unitybighead/active-marker-hardware/LED-module/README.md

# active-marker/LED-module

These circuits are desinged using KiCad 6.  
In order to order multiple boards at the same time, we will copy the wiring on the PCB editor. Since the number of parts differs from the circuit diagram, repainting the wiring will result in many errors and unconnected wiring. Please be careful when ordering board production.  
Links for NeoPixel modules are provided in LED-module.csv.

## 1655side

They are used as the four outer markers to identify the ID.

## 1655center

They are used as the center marker to identify team color.  
In the experiments, the smaller one is used.  


## 3484, 1655single
They didn't emit enough light to be used as markers, so they ended up not being used. They are left here for future reference.
