unitybighead/active-marker-hardware/LED-module/LED-module.csv

name | url
3484 | https://www.mouser.jp/ProductDetail/Adafruit/3484?qs=HXFqYaX1Q2zAi4aM%252Bec1%2Fw%3D%3D
1655 | https://www.mouser.jp/ProductDetail/Adafruit/1655?qs=GURawfaeGuATdkjqVQs49g%3D%3D
