unitybighead/active-marker-hardware/base_plate.step

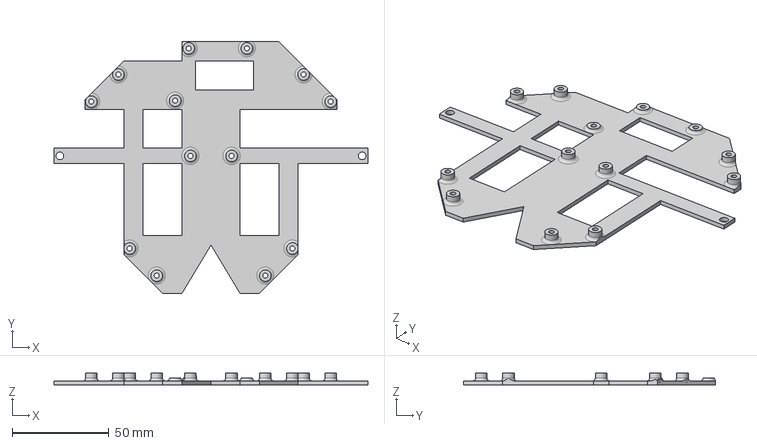
[picture p1: CAD file, 2025-02-01]
base_plate.step
162.0 x 130.0 x 6.05 mm
