unitybighead/active-marker-hardware/filter.step

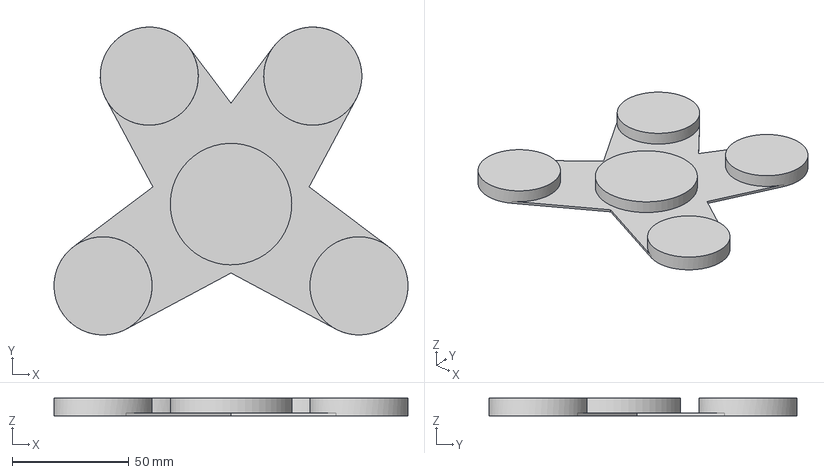
[picture p2: CAD file, 2025-02-01]
filter.step
151.5 x 131.8 x 7.50 mm
