unitybighead/active-marker-hardware/active-marker/active-marker-pcb/active-marker-pcb.kicad_pcb

## KiCad design active-marker/active-marker-pcb/active-marker-pcb.kicad_pcb (2024-10-10)

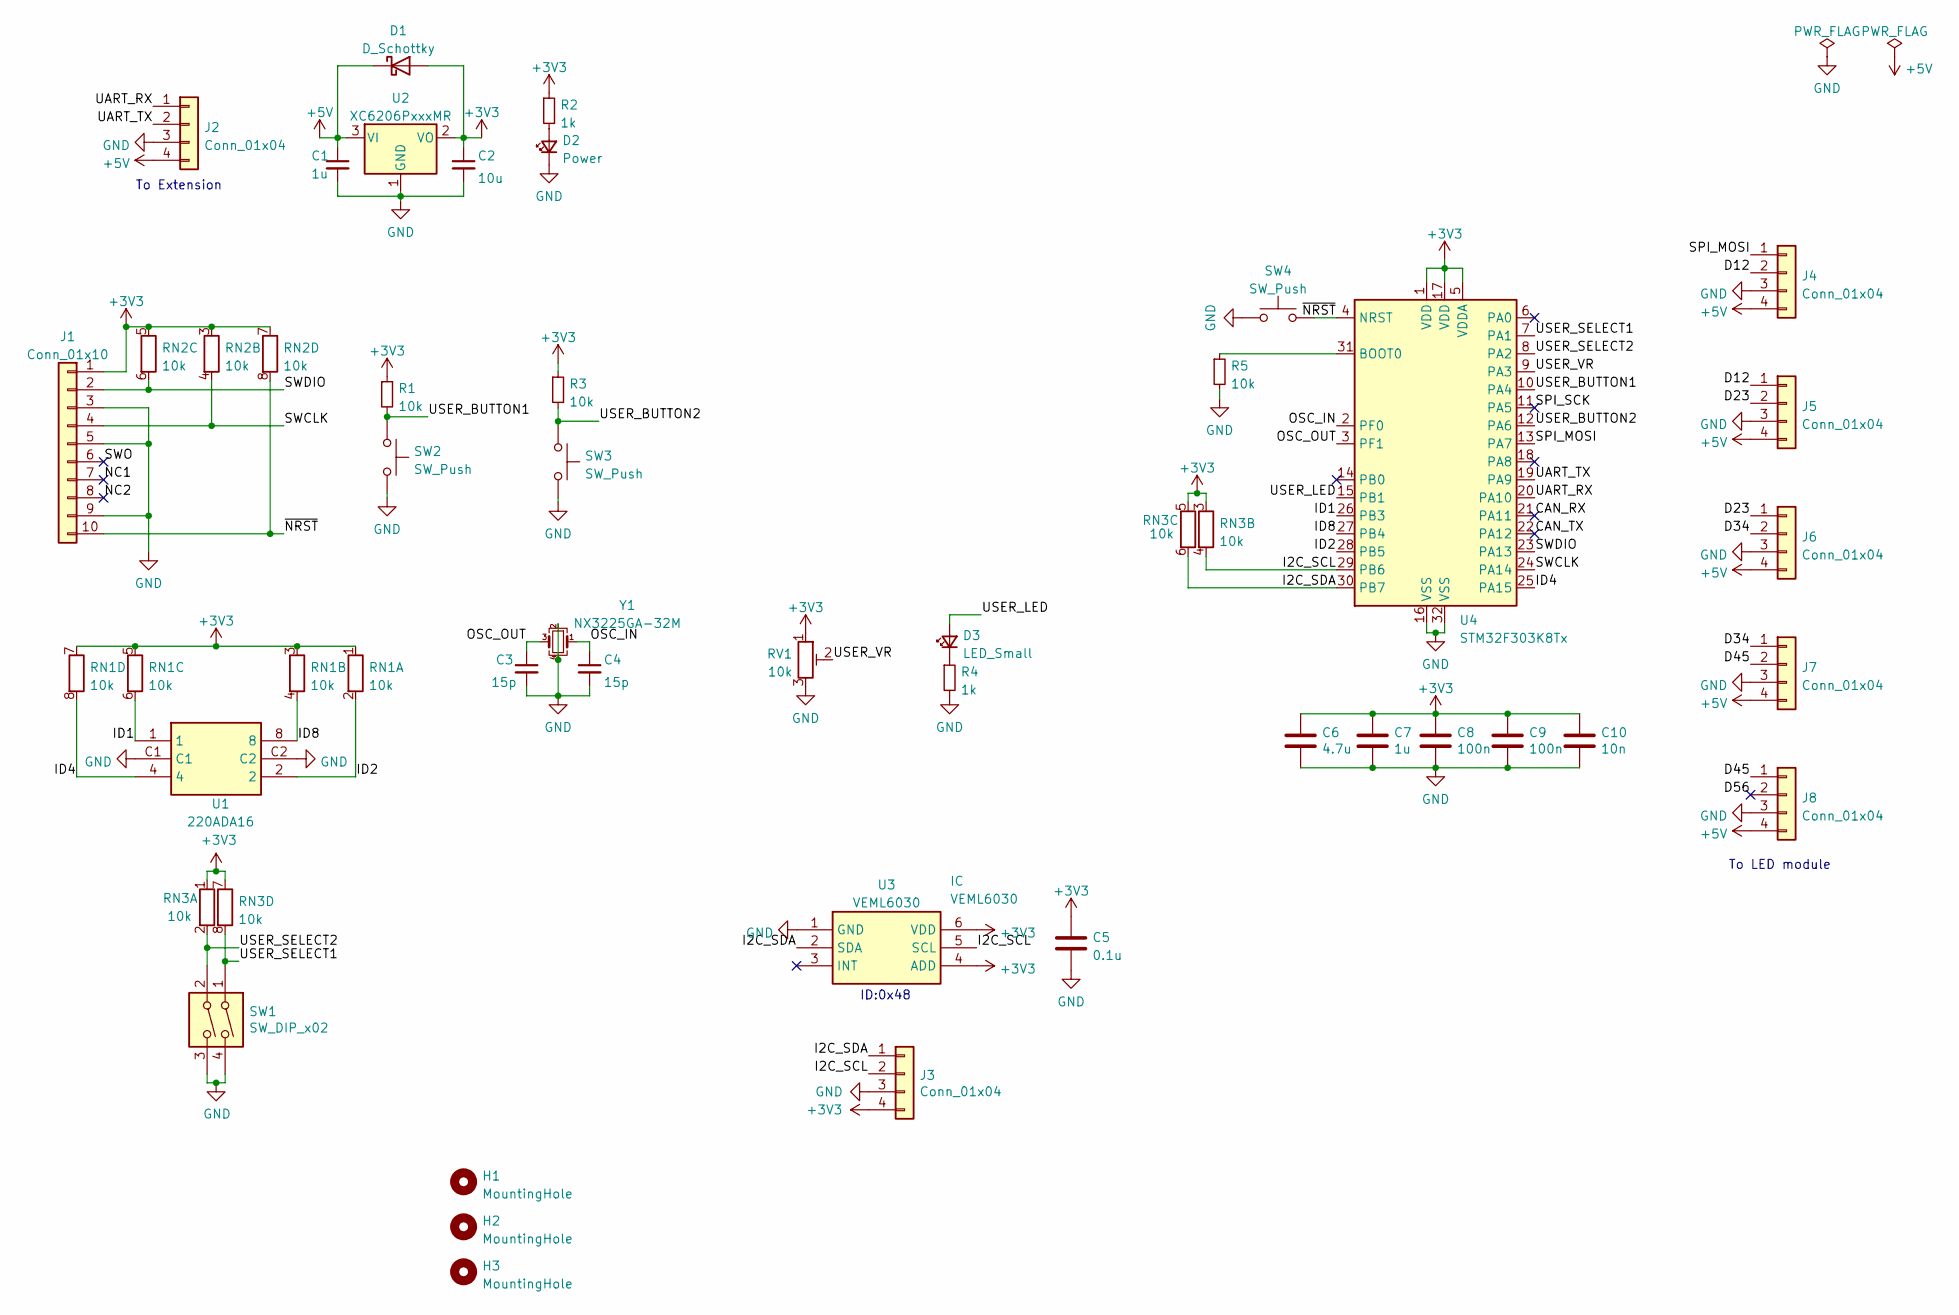
[picture p3: schematic active-marker-pcb.kicad_sch, Active Marker for RoboCup SSL]

Parts:
C1, C7: 1u; C_0603_1608Metric_Pad1.08x0.95mm_HandSolder
C2: 10u; C_0603_1608Metric_Pad1.08x0.95mm_HandSolder
C3, C4: 15p; C_0603_1608Metric_Pad1.08x0.95mm_HandSolder
C5: 0.1u; C_0603_1608Metric_Pad1.08x0.95mm_HandSolder
C6: 4.7u; C_0603_1608Metric_Pad1.08x0.95mm_HandSolder
C8, C9: 100n; C_0603_1608Metric_Pad1.08x0.95mm_HandSolder
C10: 10n; C_0603_1608Metric_Pad1.08x0.95mm_HandSolder
D1: D_Schottky; D_SOD-523
D2: Power; LED_0603_1608Metric_Pad1.05x0.95mm_HandSolder
D3: LED_Small; LED_0603_1608Metric_Pad1.05x0.95mm_HandSolder
H1, H2, H3: MountingHole; MountingHole_3.2mm_M3_ISO7380
J1: Conn_01x10; PinHeader_2x05_P1.27mm_Vertical
J2, J3, J4, J5, J6, J7, J8: Conn_01x04; JST_S4B-ZR_LF__SN_
R1, R3, R5: 10k; R_0603_1608Metric_Pad0.98x0.95mm_HandSolder
R2, R4: 1k; R_0603_1608Metric_Pad0.98x0.95mm_HandSolder
RN1, RN2, RN3: 10k; BO_CAY10_PAN-L
RV1: 10k; PVG3A202C01R00
SW1: SW_DIP_x02; DS04254202BKSMT
SW2, SW3, SW4: SW_Push; EVP6AWD40
U1: 220ADA16; Mouser Part Number 774-220ADA16
U2: XC6206PxxxMR; SOT-23-3
U3: VEML6030; Mouser Part Number 78-VEML6030
U4: STM32F303K8Tx; LQFP-32_7x7mm_P0.8mm
Y1: NX3225GA-32M; Crystal_SMD_3225-4Pin_3.2x2.5mm_HandSoldering

Connections:
/CAN_RX: U4.21 (PA11)
/CAN_TX: U4.22 (PA12)
/D12: J4.2, J5.1
/D23: J5.2, J6.1
/D34: J6.2, J7.1
/D45: J7.2, J8.1
/D56: J8.2
/I2C_SCL: J3.2, RN3.4 (R2.2), U3.5 (SCL), U4.29 (PB6)
/I2C_SDA: J3.1, RN3.6 (R3.2), U3.2 (SDA), U4.30 (PB7)
/ID1: RN1.6 (R3.2), U1.1, U4.26 (PB3)
/ID2: RN1.2 (R1.2), U1.2, U4.28 (PB5)
/ID4: RN1.8 (R4.2), U1.4, U4.25 (PA15)
/ID8: RN1.4 (R2.2), U1.8, U4.27 (PB4)
/NC1: J1.7
/NC2: J1.8
/OSC_IN: C4.1, U4.2 (PF0), Y1.1
/OSC_OUT: C3.1, U4.3 (PF1), Y1.3
/SPI_MOSI: J4.1, U4.13 (PA7)
/SPI_SCK: U4.11 (PA5)
/SWCLK: J1.4, RN2.4 (R2.2), U4.24 (PA14)
/SWDIO: J1.2, RN2.6 (R3.2), U4.23 (PA13)
/SWO: J1.6
/UART_RX: J2.1, U4.20 (PA10)
/UART_TX: J2.2, U4.19 (PA9)
/USER_BUTTON1: R1.2, SW2.1, U4.10 (PA4)
/USER_BUTTON2: R3.2, SW3.1, U4.12 (PA6)
/USER_LED: D3.2 (A), U4.15 (PB1)
/USER_SELECT1: RN3.8 (R4.2), SW1.1, U4.7 (PA1)
/USER_SELECT2: RN3.2 (R1.2), SW1.2, U4.8 (PA2)
/USER_VR: RV1.2, U4.9 (PA3)
/~NRST: J1.10, RN2.8 (R4.2), SW4.1, U4.4 (NRST)
GND: C1.2, C2.2, C3.2, C4.2, C5.2, C6.2, C7.2, C8.2, C9.2, C10.2, D2.1 (K), J1.3, J1.5, J1.9, J2.3, J3.3, J4.3, J5.3, J6.3, J7.3, J8.3, R4.2, R5.2, RV1.3, SW1.3, SW1.4, SW2.2, SW3.2, SW4.2, U1.C1, U1.C2, U2.1 (GND), U3.1 (GND), U4.16 (VSS), U4.32 (VSS), Y1.2, Y1.4; also elsewhere on the board
unnamed: D2.2 (A), R2.2
unnamed: D3.1 (K), R4.1
unnamed: R5.1, U4.31 (BOOT0)

Notes on the sheet:
ID:0x48
To LED module
To Extension

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
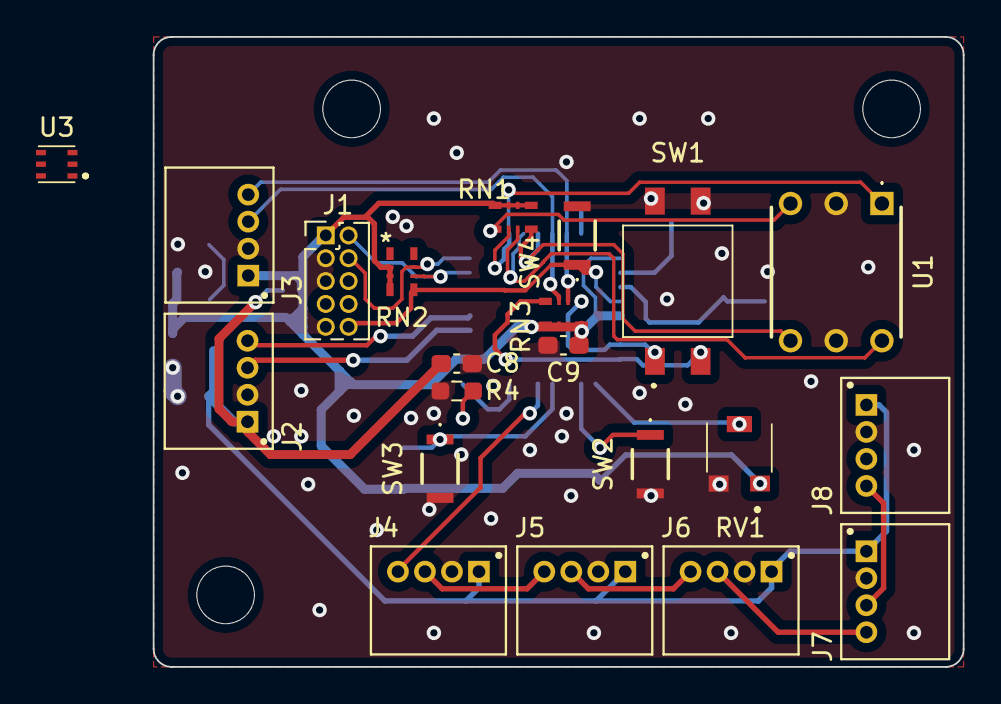
[picture p4: board active-marker-pcb.kicad_pcb from above]

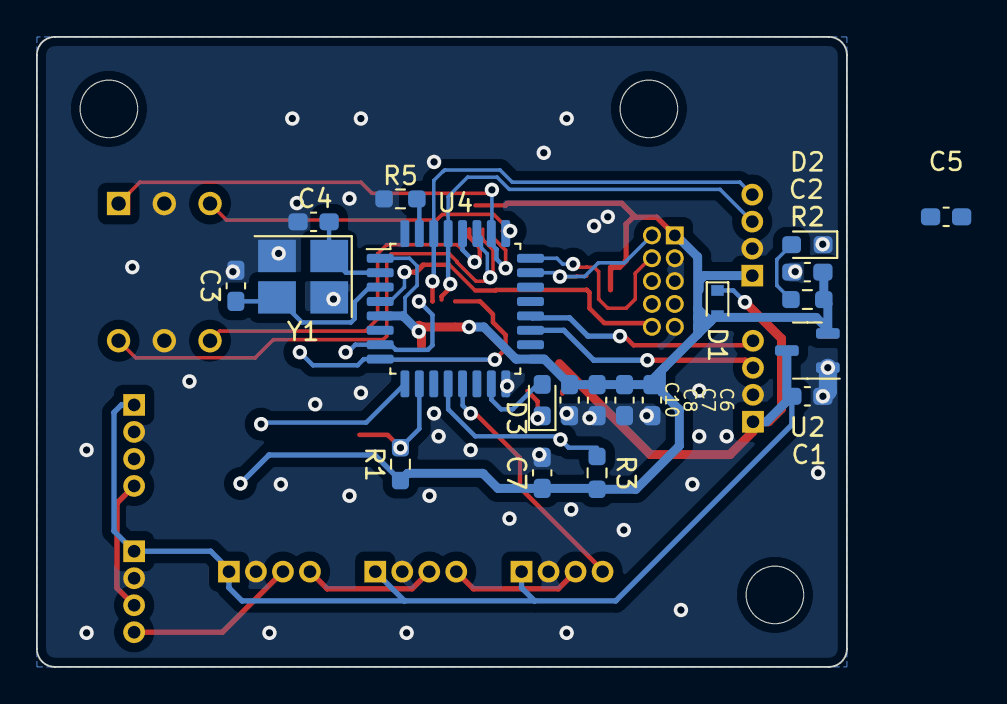
[picture p5: board active-marker-pcb.kicad_pcb from below]

Board: 2 copper layers, 45.0 x 35.0 mm, 44 parts (20 on the bottom side), 30 nets.

Other parts of the board:
C7#2: 1u; C_0603_1608Metric_Pad1.08x0.95mm_HandSolder
C8#2: 100n; C_0603_1608Metric_Pad1.08x0.95mm_HandSolder

Their connections:
GND: C7#2.2, C8#2.2; also elsewhere on the board
