unitybighead/active-marker-hardware/VEML6030-breakout/VEML6030-breakout-pcb/VEML6030-breakout.kicad_pcb

## KiCad design VEML6030-breakout/VEML6030-breakout-pcb/VEML6030-breakout.kicad_pcb (2024-05-09)

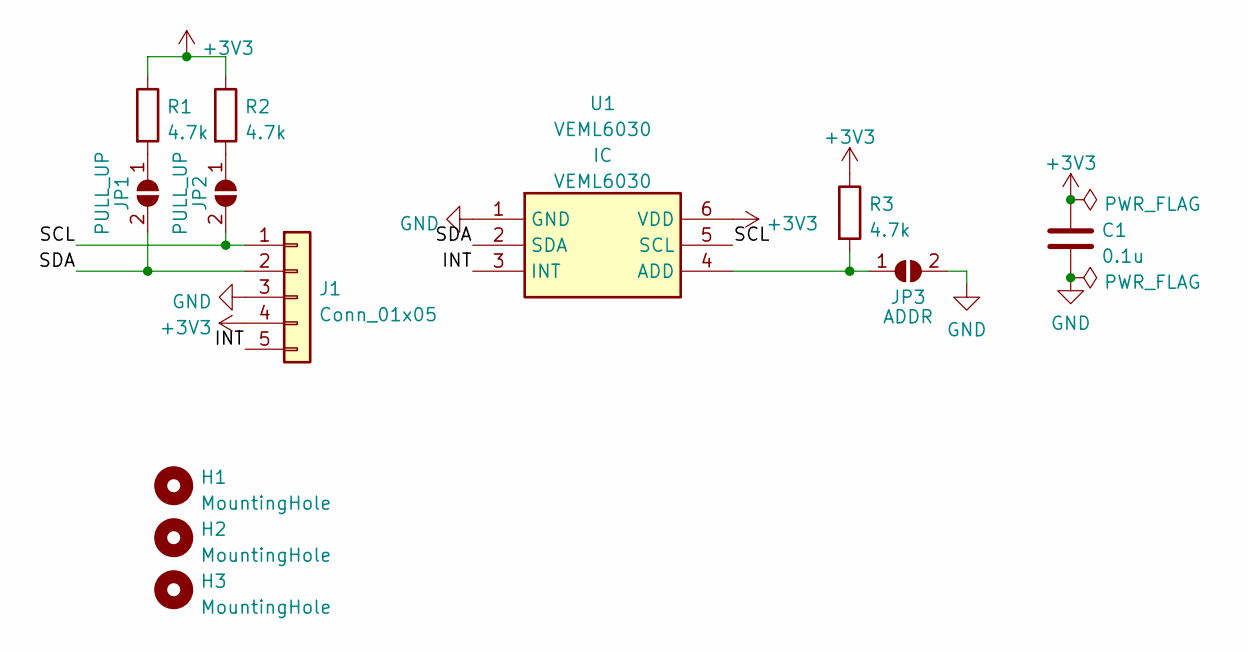
[picture p6: schematic VEML6030-breakout.kicad_sch, VEML6030 Breakout Board]

Parts:
C1: 0.1u; C_0603_1608Metric_Pad1.08x0.95mm_HandSolder
H1, H2, H3: MountingHole; MountingHole_3.2mm_M3_ISO7380
J1: Conn_01x05; JST_XH_S5B-XH-A_1x05_P2.50mm_Horizontal
JP1, JP2: PULL_UP; SolderJumper-2_P1.3mm_Open_Pad1.0x1.5mm
JP3: ADDR; SolderJumper-2_P1.3mm_Open_Pad1.0x1.5mm
R1, R2, R3: 4.7k; R_0603_1608Metric_Pad0.98x0.95mm_HandSolder
U1: VEML6030; Mouser Part Number 78-VEML6030

Connections:
+3V3: C1.1, J1.4, R1.1, R2.1, R3.1, U1.6 (VDD)
/INT: J1.5, U1.3 (INT)
/SCL: J1.1, JP2.2 (B), U1.5 (SCL)
/SDA: J1.2, JP1.2 (B), U1.2 (SDA)
GND: C1.2, J1.3, JP3.2 (B), U1.1 (GND)
unnamed: JP1.1 (A), R1.2
unnamed: JP2.1 (A), R2.2
unnamed: JP3.1 (A), R3.2, U1.4 (ADD)

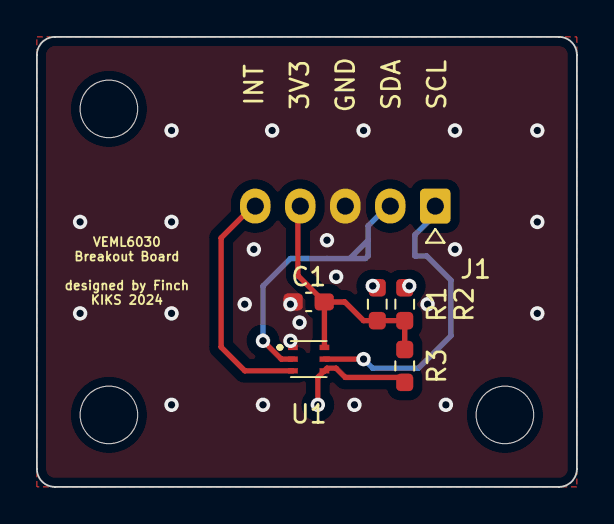
[picture p7: board VEML6030-breakout.kicad_pcb from above]

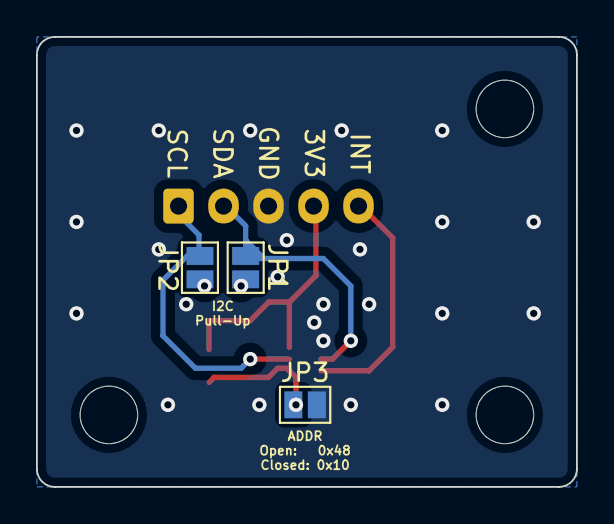
[picture p8: board VEML6030-breakout.kicad_pcb from below]

Board: 2 copper layers, 30.0 x 25.0 mm, 12 parts (3 on the bottom side), 8 nets.
