unitybighead/active-marker-hardware/active-marker/STM32/active_marker/Core/Src/main.c

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
/* Includes ------------------------------------------------------------------*/
#include "main.h"

/* USER CODE BEGIN Includes */
#include "active_marker.h"
#include "user_func.h"
#include "VEML6030.h"
/* USER CODE END Includes */

/* USER CODE BEGIN PTD */
typedef enum {
  CYCLE_MAIN, CYCLE_SENSOR, CYCLE_PATTERN, CYCLE_LAST
} Cycle_enum;
/* USER CODE END PTD */

CAN_HandleTypeDef hcan;

I2C_HandleTypeDef hi2c1;

IWDG_HandleTypeDef hiwdg;

SPI_HandleTypeDef hspi1;
DMA_HandleTypeDef hdma_spi1_tx;

UART_HandleTypeDef huart1;

void SystemClock_Config(void);
static void MX_GPIO_Init(void);
static void MX_DMA_Init(void);
static void MX_SPI1_Init(void);
static void MX_USART1_UART_Init(void);
static void MX_CAN_Init(void);
static void MX_I2C1_Init(void);
static void MX_IWDG_Init(void);
/**
 * @brief  The application entry point.
 * @retval int
 */
int main(void) {
  /* USER CODE BEGIN 1 */
  uint8_t ID = 0;
  bool color = TEAM_COLOR_YELLOW;
  /* USER CODE END 1 */

  /* MCU Configuration--------------------------------------------------------*/

  /* Reset of all peripherals, Initializes the Flash interface and the Systick. */
  HAL_Init();

  /* Configure the system clock */
  SystemClock_Config();

  /* Initialize all configured peripherals */
  MX_GPIO_Init();
  MX_DMA_Init();
  MX_SPI1_Init();
  MX_USART1_UART_Init();
  MX_CAN_Init();
  MX_I2C1_Init();
  MX_IWDG_Init();
  /* USER CODE BEGIN 2 */
  VEML6030_init(&hi2c1, SENS_ADDR_0);
//  VEML6030_init(&hi2c1, SENS_ADDR_1);
  HAL_Delay(50);
  NeoPixel_Init(&hspi1);
  Uart_Init(&huart1);
  setColorSwitch();
  setIDSwitch();
//setup cycle
  float *cycle_basis = calloc(CYCLE_LAST, sizeof(float));
  uint32_t *cycle_old = calloc(CYCLE_LAST, sizeof(uint32_t));
  cycle_basis[CYCLE_MAIN] = 20;
  cycle_basis[CYCLE_PATTERN] = 50;
  cycle_basis[CYCLE_SENSOR] = VEML6030_getIntTime(SENS_ADDR_0);
  /* USER CODE END 2 */

  /* Infinite loop */
  /* USER CODE BEGIN WHILE */
  while (1) {
    ID = getID();
    color = getColor();
    if (CycleController(CYCLE_PATTERN, cycle_basis, cycle_old)) {
      setPattern(ID, color);
    }

    if(CycleController(CYCLE_SENSOR, cycle_basis, cycle_old)){
      uint16_t lux = (uint16_t)VEML6030_getLux(SENS_ADDR_0);
      uint8_t data[8] = {};
      data[0] = COMMAND_ILLUMINANCE;
      data[1] = lux & 0xFF;
      data[2] = lux >> 8;
      HAL_UART_Transmit(&huart1, data, 8, 10);
    }

    while (!CycleController(CYCLE_MAIN, cycle_basis, cycle_old)) {
      HAL_Delay(1);
    }
    Uart_checkReset();
    HAL_IWDG_Refresh(&hiwdg);
  /* USER CODE END WHILE */

  /* USER CODE BEGIN 3 */
}
/* USER CODE END 3 */
}

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
