unitybighead/active-marker-hardware/active-marker/STM32/active_marker/active_marker.ioc

Mcu.UserName=STM32F303K6Tx
PA1.GPIO_Label=MODE
PA1.Signal=GPIO_Input
PA10.Signal=USART1_RX
PA11.Signal=CAN_RX
PA12.Signal=CAN_TX
PA13.Signal=SYS_JTMS-SWDIO
PA14.Signal=SYS_JTCK-SWCLK
PA15.GPIO_Label=ID4
PA15.Signal=GPIO_Input
PA2.GPIO_Label=COLOR
PA2.Signal=GPXTI2
PA3.GPIO_Label=USER_VR
PA3.Signal=GPIO_Analog
PA4.GPIO_Label=USER_BTN1
PA4.Signal=GPXTI4
PA5.Signal=SPI1_SCK
PA6.GPIO_Label=USER_BTN2
PA6.Signal=GPXTI6
PA7.Signal=SPI1_MOSI
PA9.Signal=USART1_TX
PB1.GPIO_Label=USER_LED
PB1.Signal=GPIO_Output
PB3.GPIO_Label=ID1
PB3.Signal=GPXTI3
PB4.GPIO_Label=ID8
PB4.Signal=GPIO_Input
PB5.GPIO_Label=ID2
PB5.Signal=GPXTI5
PB6.Signal=I2C1_SCL
PB7.Signal=I2C1_SDA
