unitybighead/active-marker-hardware/active-marker/STM32/active_marker/Core/Inc/user_func.h

/*
 * user_func.h
 *
 *  Created on: 2024/05/23
 *      Author: harub
 */

#ifndef INC_USER_FUNC_H_
#define INC_USER_FUNC_H_

#include "main.h"
#include "stdbool.h"
#include "malloc.h"

bool CycleController(int data, float *basis, uint32_t *old);

#endif /* INC_USER_FUNC_H_ */
