unitybighead/active-marker-hardware/(commit log)

2024-05-09 add VEML6030 breakout board
    [VEML6030-breakout.kicad_pcb, VEML6030-breakout.kicad_sch]
2024-05-16 add gerber files
2024-05-16 add active-marker mother board pcb
    [active-marker-pcb.kicad_pcb, active-marker-pcb.kicad_sch]
2024-05-16 fix Pinmap and add some vias
    [active-marker-pcb.kicad_pcb, active-marker-pcb.kicad_sch]
2024-05-16 plot gerber file
    [active-marker-pcb-B_Cu.gbr, active-marker-pcb-B_Mask.gbr, active-marker-pcb-B_Paste.gbr, active-marker-pcb-B_Silkscreen.gbr, active-marker-pcb-Edge_Cuts.gbr, active-marker-pcb-F_Cu.gbr, active-marker-pcb-F_Mask.gbr, active-marker-pcb-F_Paste.gbr]
2024-05-16 add LED-module
    [LED-module.kicad_pcb, LED-module.kicad_sch]
2024-05-16 add diode, fix gerber files
    [active-marker-pcb-B_Cu.gbr, active-marker-pcb-B_Mask.gbr, active-marker-pcb-B_Paste.gbr, active-marker-pcb-B_Silkscreen.gbr, active-marker-pcb-Edge_Cuts.gbr, active-marker-pcb-F_Cu.gbr, active-marker-pcb-F_Mask.gbr, active-marker-pcb-F_Paste.gbr]
2024-05-18 fix a placement of mounting hole
    [active-marker-pcb.kicad_pcb]
2024-05-18 fix pinmap of ZH4 connector
    [LED-module.kicad_pcb]
2024-05-23 add STM32 files
    auto-generated files will be managed
2024-05-30 add VEML6030_test and fix library
    [VEML6030.c, VEML6030.h, VEML6030_test.ioc, main.c, main.h, user_func.c, user_func.h]
2024-06-14 add neopixel_test, active_marker
    [active-marker-pcb.csv]
2024-06-19 fixed spi settings and it can be used as marker
    [active_marker.ioc, main.c, neopixel_spi.c, neopixel_spi.h]
2024-07-22 add 1655 module (bigger)
    [1655.kicad_pcb, 1655.kicad_sch]
2024-08-01 M5StickCにudp機能を追加
2024-08-05 UARTに対応させた 要デバッグ
2024-08-05 spiのNSSPが勝手に変わっていた
2024-08-06 Illuminaceのデータを受け取れるように
2024-08-08 colorの処理を変更
2024-08-20 ボタン等に割り込み対応
2024-08-21 add LED matrix
    [1655array.kicad_pcb, 1655array.kicad_sch]
2024-08-23 add clearance
    [1655array.kicad_pcb]
2024-09-21 uart信号が正常に届かない場合リセットを掛ける
2024-09-21 uartを高速化、その他動作の安定化を図る
2024-11-05 brkoutを修正
2024-11-06 外付け照度センサを有効化
2025-02-01 rename 3484
    [3484.kicad_pcb, 3484.kicad_sch]
2025-02-01 rename center single
    [1655.kicad_pcb, 1655.kicad_sch, 1655center.kicad_pcb, 1655center.kicad_sch]
2025-02-01 add side
    [1655side.kicad_pcb, 1655side.kicad_sch]
2025-02-01 add led module list
    [LED-module.csv]
2025-02-01 rename outer
    [1655outer.kicad_pcb, 1655outer.kicad_sch]
2025-02-01 add .step
    [base_plate.step, filter.step]
2025-02-01 replace .step
    [base_plate.step, filter.step]
