unitybighead/active-marker-hardware/(notices)

Notices in the files:
active-marker/STM32/active_marker/Core/Inc/main.h:
Copyright (c) 2024 STMicroelectronics.
All rights reserved.
This software is licensed under terms that can be found in the LICENSE file
